xiaolai13138/drawing-board/altium desigener/主板RT1064/原理图 RT1064主板 V3.0.1.1 (1).pdf

D | D
C | C
B | B
A | A
RT1064_MotherBoard | 追猎者
| V3.0.1.1
2023/5/8 | 17:56:21
Title: | Author:

Date:

Revision:

Size: A4 | Time: | Sheet: | of:

Subtitle: Revision

V1.3

正式售卖的第一个版本
V2.0

内部迭代，未销售
V2.1

稳压方案更换为SY8205
增加2个舵机接口，与电机驱动信号接口2复用
增加USART4接口，方便连接OpenART mini

电源开关更换为软开关，避免电弧造成开关损耗

HC-SR1一体式超声波接口变更为3.3V供电
增加CR引脚延时泄放二极管

(2021)

(2020)

V2.2

减小电机PWM信号上串接的电阻为100R
稳压方案替换为SCT2450

(内部迭代)

用户按键及拨码开关增加100R串联电阻
USART4 USART1 无线串口接口，增加供电时序控制电路 软开关更改为P-MOS，断VCC的方案

V2.3 (2022)

更正软开关电路

UART1 UART4 无线串口接口的5V引脚丝印标注更改为5V*

USART1 USART4 丝印标注更改为 UART1 UART4

V3.0 (2022)

5V稳压输出端增加SS54二极管
去掉FlexCom摄像头接口
重新分配电机、舵机、编码器、按键、拨码开关引脚。
增加SPI-无线模块接口
增加磁铁检测模块接口

5V稳压和舵机稳压更换为SP1N28STER

# SEEKFREE

# SS54 SEEKFREE

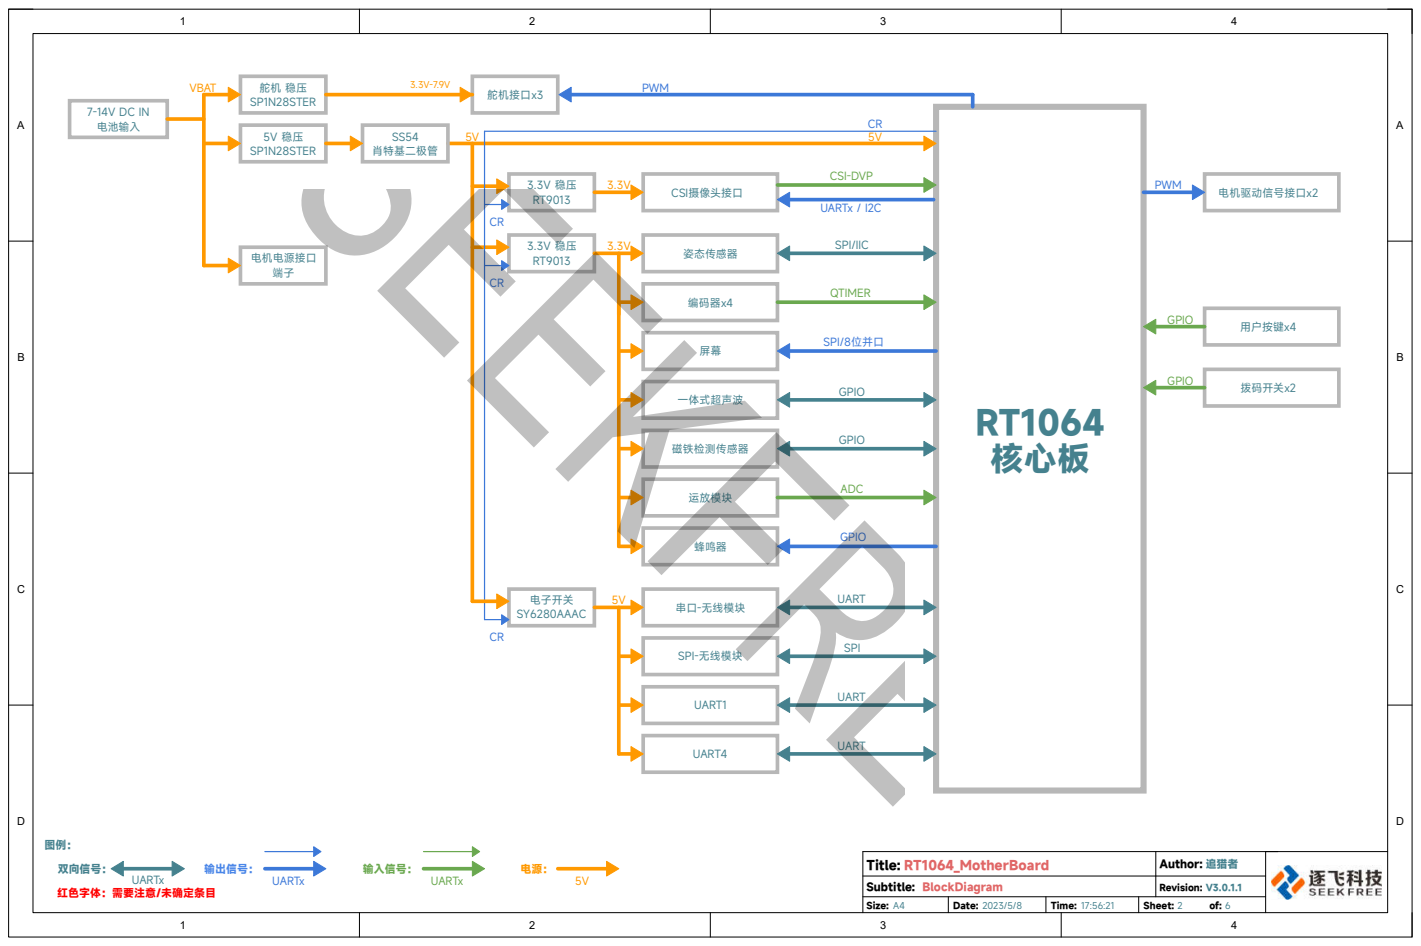
[picture p1: page 2]
RT1064_MotherBoard; 追猎者; Title:; Author:; Revision:; Subtitle: BlockDiagram; 双向信号：; 输出信号：; 输入信号：; 5V 稳压 SP1N28STER; VBAT; 电池输入; 舵机 稳压 SP1N28STER; 电机电源接口 端子; 舵机接口x3 ³.3V-7.9V; CSI摄像头接口; 姿态传感器; 编码器x4; SPI-无线模块; 一体式超声波; UART1; UART4; UARTx / I2C; UARTx; CSI-DVP; SPI/IIC; QTIMER; SPI/8位并口; 电子开关 SY6280AAAC; GPIO; 串口-无线模块; 磁铁检测传感器; UART; SPI; PWM; 运放模块; 蜂鸣器; ADC; 电机驱动信号接口x2 PWM; 用户按键x4 GPIO; 拨码开关x2 GPIO; RT1064 核心板; 肖特基二极管

红色字体：需要注意/未确定条目

# RT1064核心板

## 外设 功能

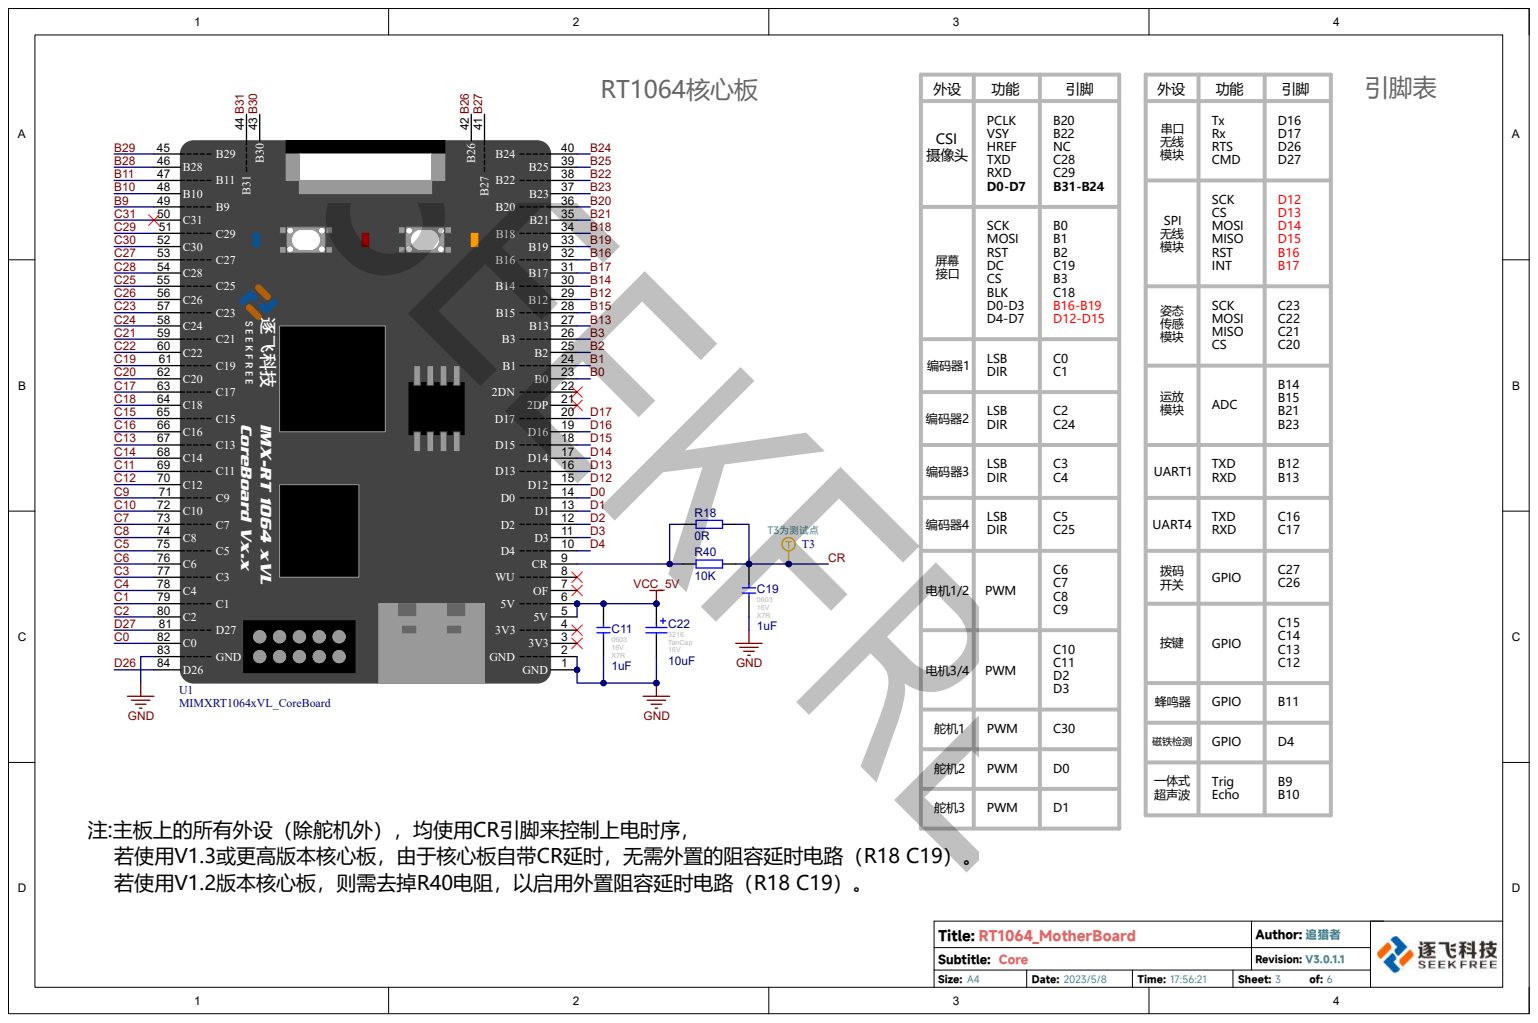
[picture p2: page 3]

SPI 无线 模块 | SCK CS MOSI MISO RST INT | D12 D13 D14 D15 B16 B17

屏幕 接口 | SCK MOSI RST DC CS BLK D0-D3 D4-D7 | B0 B1 B2 C19 B3 C18 B16-B19 D12-D15

姿态 传感 模块 | SCK MOSI MISO CS | C23 C22 C21 C20

编码器1 | LSB DIR | C0 C1

运放 模块 | ADC | B14 B15 B21 B23

编码器2 | LSB DIR | C2 C24

按键 | GPIO | C15 C14 C13 C12

电机3/4 | PWM | C10 C11 D2 D3

蜂鸣器 | GPIO | B11

舵机1 | PWM | C30

磁铁检测 | GPIO | D4

舵机2 | PWM | D0

一体式 超声波 | Trig Echo | B9 B10

舵机3 | PWM | D1

# CSI摄像头接口

# 姿态传感模块接口

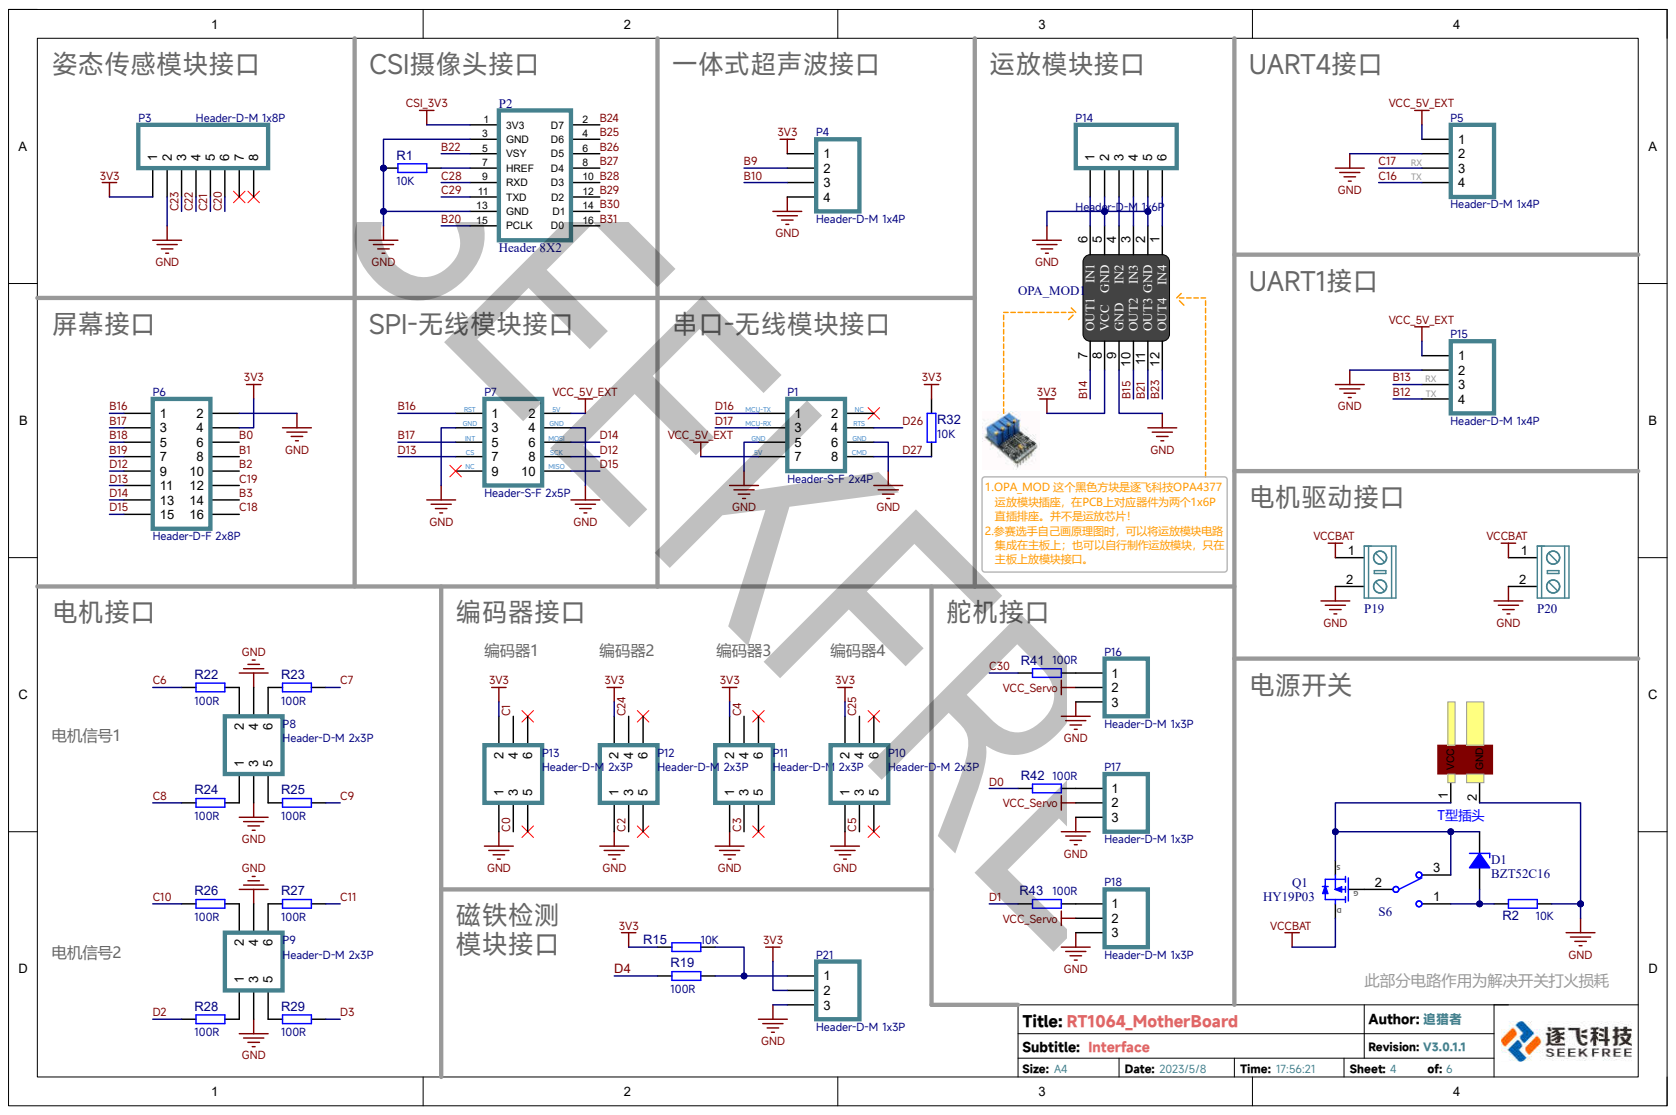
[picture p3: page 4]

# 3V3电源

# 舵机稳压电路

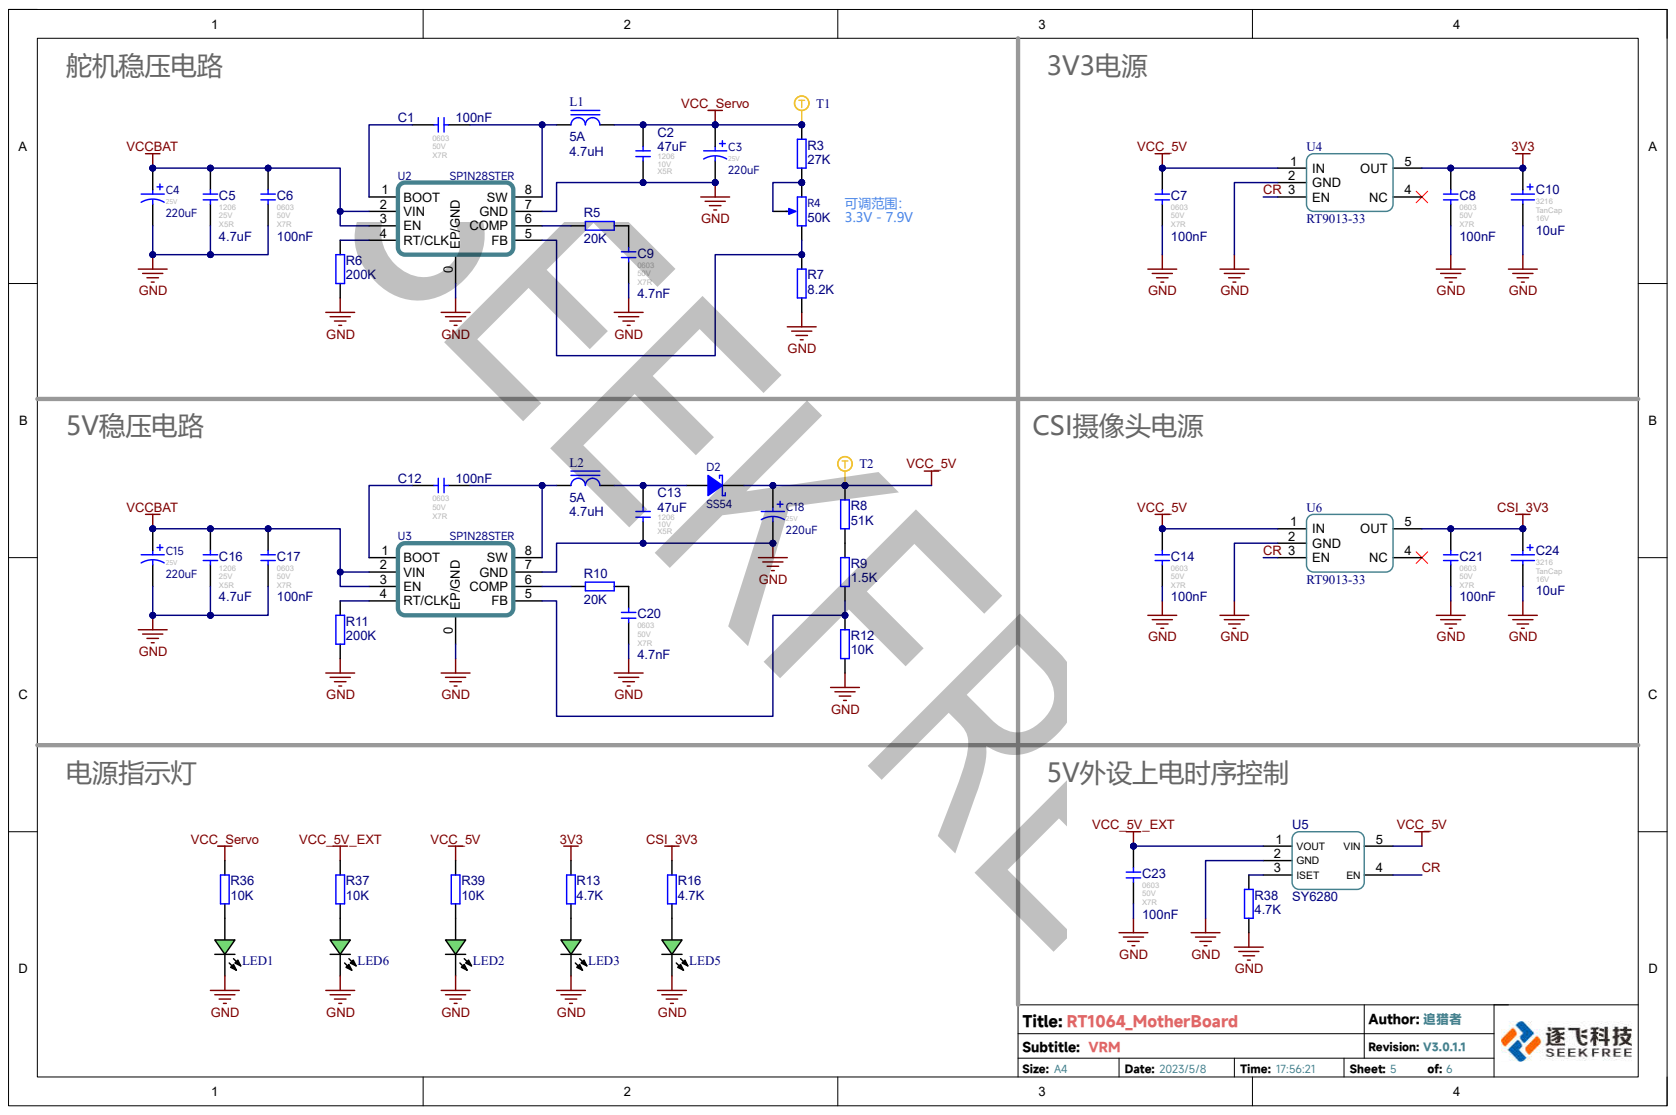
[picture p4: page 5]

# 蜂鸣器 拨码开关/按键

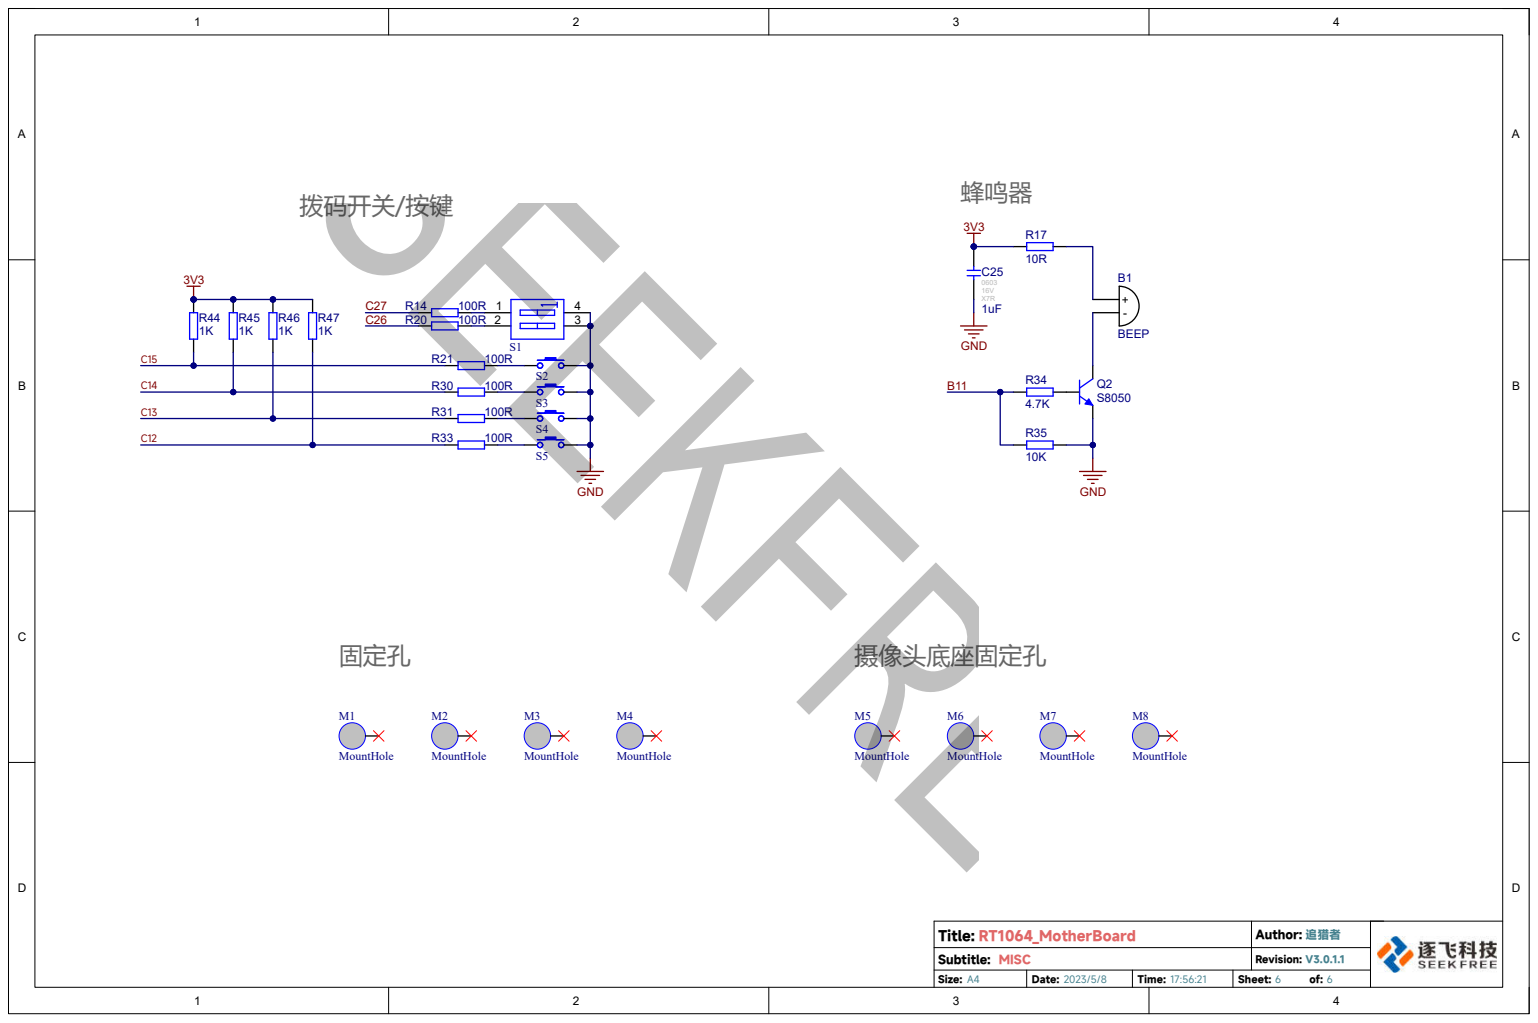
[picture p5: page 6]
