xiaolai13138/drawing-board/altium desigener/驱动板DRV8701E/DRV8701E_V1/DRV8701E_V1.pdf

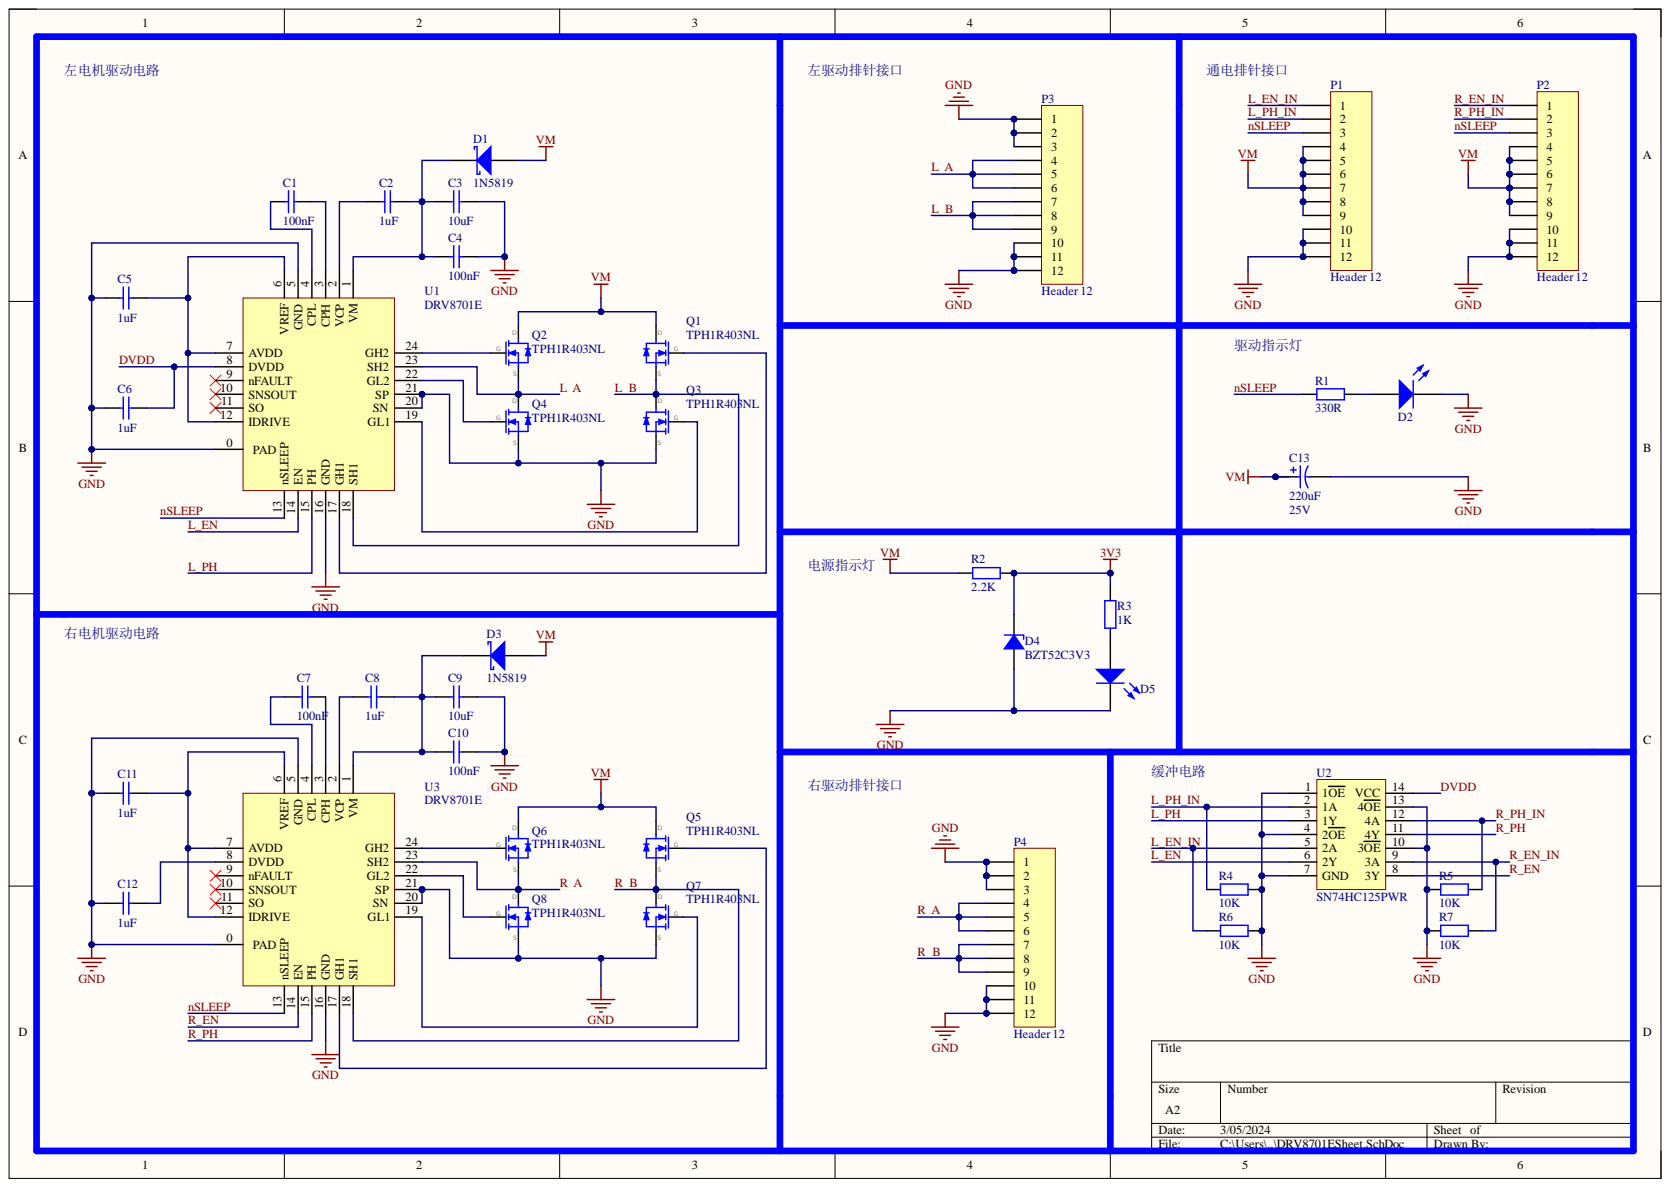
[picture p13: page 1]

VM 1 VCP 2 CPH 3 CPL 4 GND 5 VREF 6 nSLEEP 13

Size A2 | Number | Revision

Date: 3/05/2024 | Sheet of
File: C:\Users\..\DRV8701ESheet.SchDoc | Drawn By:

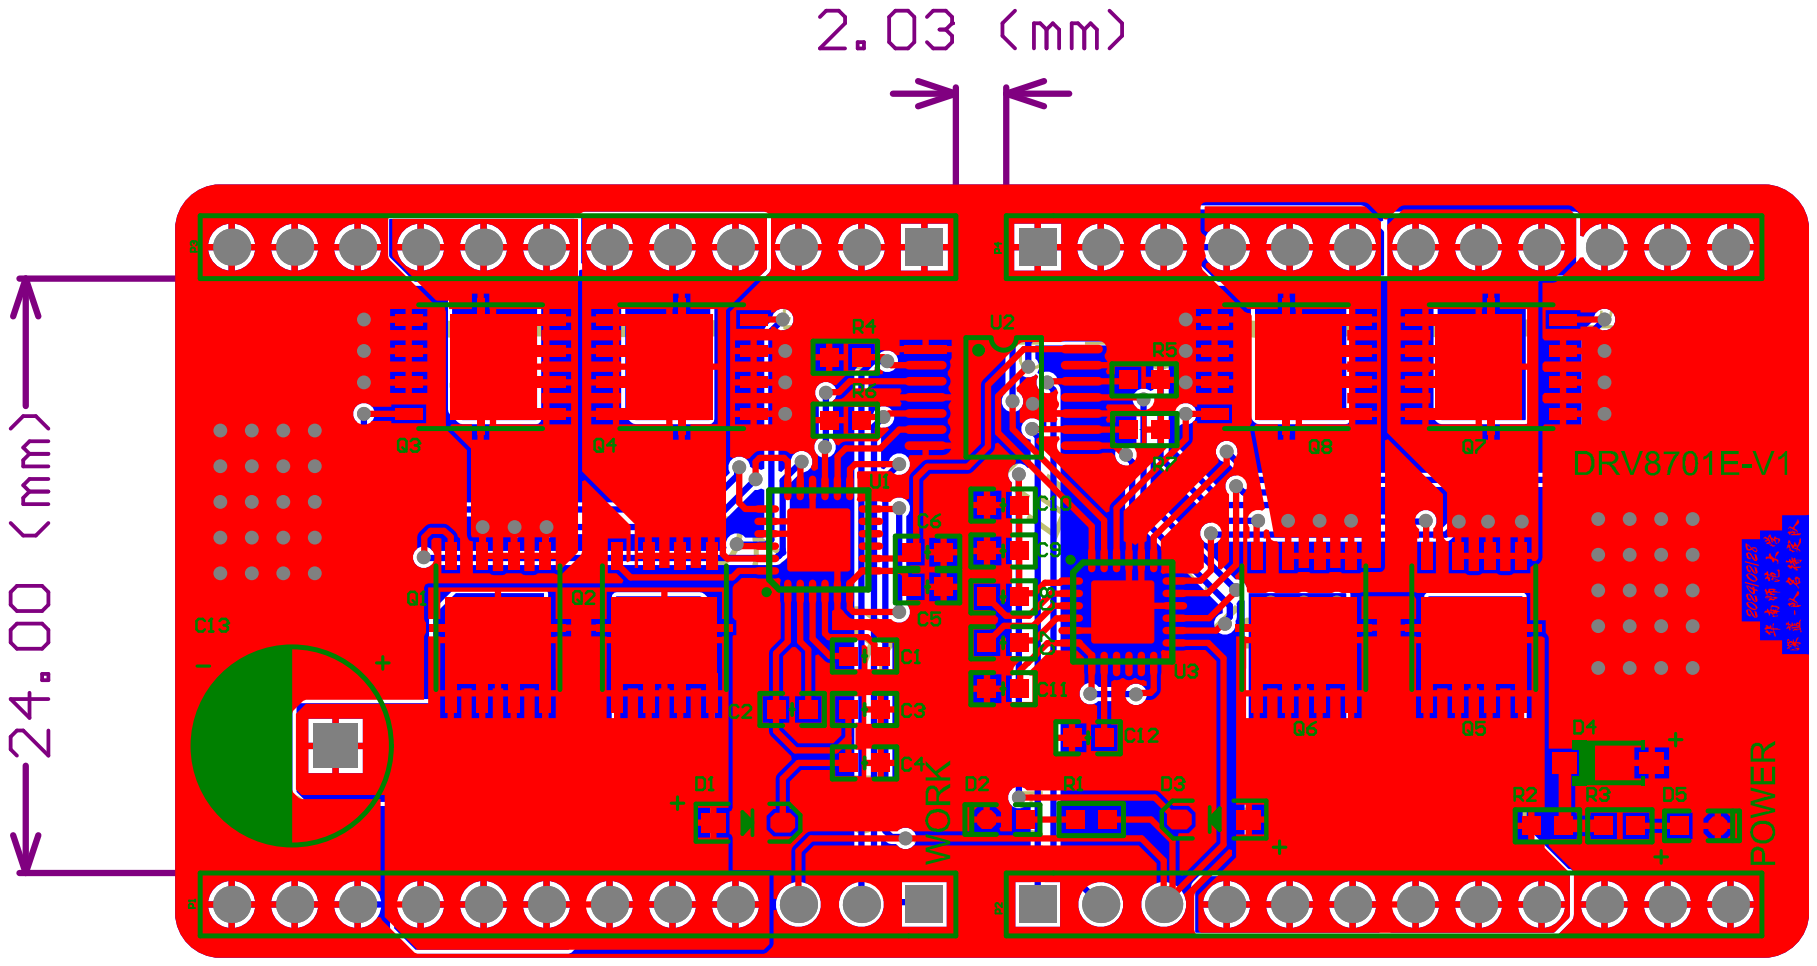
[picture p14: page 2]

Comment | Description | Designator | Footprint | LibRef | Quantity
100nF | 贴片电容 | C1, C4, C7, C10 | C0603_L | C-SMD | 4
1uF | 贴片电容 | C2, C5, C6, C8, C11, C12 | C0603_L | C-SMD | 6
10uF | 贴片电容 | C3, C9 | C0603_L | C-SMD | 2
220uF 25V | Polarized Capacitor (Radial) | C13 | CAPPR3.5-8X11.5 | Cap-Elect | 1
1N5819 | 肖特基二极管 | D1, D3 | SOD-323 | 1N5819 | 2
LED | 贴片发光二极管 | D2, D5 | LED-0603_R | LED_SMD | 2
BZT52C3V3 | 3.3V稳压二极管 | D4 | SOD-123-L | Diode Zen | 1
Header 12 | Header, 12-Pin | P1, P2, P3, P4 | HDR1X12 | Header 12 | 4
TPH1R403NL | N沟道MOS | Q1, Q2, Q3, Q4, Q5, Q6, Q7, Q8 | DFN5x6 | TPH1R403NL | 8
330R | 贴片电阻 | R1 | R0603_L | R-SMD | 1
2.2K | 贴片电阻 | R2 | R0603_L | R-SMD | 1
1K | 贴片电阻 | R3 | R0603_L | R-SMD | 1
10K | 贴片电阻 | R4, R5, R6, R7 | R0603_L | R-SMD | 4
DRV8701E | DRV8701E Ti全桥驱 动芯片 | U1, U3 | QFN24-4x4 | DRV8701E | 2
SN74HC125PWR | 三态输出的四路缓 冲器 | U2 | TSSOP14 | SN74HC125PWR | 1
