xiaolai13138/drawing-board/(list of files, drawings)

Other design files:
altium desigener/主板RT1064/RT1064_V1/RT1064_V1/RT1064_V1.PrjPcb
altium desigener/主板RT1064/RT1064_V1/RT1064_V1主板器件封装集成库/RT1064_V1主板器件封装集成库/Project Outputs for RT1064_V1主板器件封装集成库/RT1064_V1主板器件封装集成库/RT1064_MotherBoard V3.SCHLIB
altium desigener/主板RT1064/RT1064_V1/RT1064_V1主板器件封装集成库/RT1064_V1主板器件封装集成库/RT1064_MotherBoard V3.SCHLIB
altium desigener/主板RT1064/RT1064_V1/RT1064_V2/board/board/board.PrjPcb
altium desigener/主板RT1064/RT1064_V1/RT1064_V2/board/board/boardPCB.PcbDoc
altium desigener/主板RT1064/RT1064_V1/RT1064_V2/board/board/boardSheet.SchDoc
altium desigener/主板RT1064/RT1064_V1/RT1064_V2/RT1064/RT1064_CoreBoard.SchDoc
altium desigener/主板RT1064/RT1064_V1/RT1064_V2/RT1064/RT1064_Device.SchDoc
altium desigener/主板RT1064/RT1064_V1/RT1064_V2/RT1064/RT1064_Interaction.SchDoc
altium desigener/主板RT1064/RT1064_V1/RT1064_V2/RT1064/RT1064_Power.SchDoc
altium desigener/主板RT1064/RT1064_V1/RT1064_V2/RT1064/RT1064_V1/RT1064_V1.SCHLIB
altium desigener/主板RT1064/RT1064_V1/RT1064_V2/RT1064/RT1064_V2.PrjPcb
altium desigener/主板RT1064/RT1064_V1/RT1064_V2/RT1064/RT1064_V11/RT1064_V1.SCHLIB
altium desigener/主板RT1064/RT1064_V1/排母.SchLib
altium desigener/驱动板DRV8701E/DRV8701E_V1/DRV8701EPCB.PcbDoc
altium desigener/驱动板DRV8701E/DRV8701E_V3/DRV8701E_V1.PrjPcb
altium desigener/驱动板DRV8701E/DRV8701E_V3/DRV8701ESheet.SchDoc
