xiaolai13138/drawing-board/(commit log)

2024-02-25 驱动板工程初建
    [DRV8701EPCB.PcbDoc, DRV8701ESheet.SchDoc, DRV8701E_V1.PrjPcb, 智能车驱动板DRV8701E.SCHLIB]
2024-02-27 四层板层叠设置
    [智能车驱动板DRV8701E.SCHLIB]
2024-02-27 模块化布局1
    [DRV8701EPCB.PcbDoc, DRV8701ESheet.SchDoc, DRV8701E_V1.PrjPcb]
2024-02-27 模块化布局2
    [DRV8701EPCB.PcbDoc]
2024-02-28 布线+过孔
    [DRV8701EPCB.PcbDoc, DRV8701ESheet.SchDoc, DRV8701E_V1.PrjPcb]
2024-02-29 驱动板优化布线+铺铜
    [DRV8701EPCB.PcbDoc]
2024-02-29 修改丝印与加队名
    [DRV8701ESheet.SchDoc, DRV8701E_V1.PrjPcb, DRV8701E_V1购买清单.xlsx]
2024-02-29 丝印调整位置
2024-03-01 RT1064绘制原理图1
    [DRV8701EPCB_Copper_Plane_1.gbr, DRV8701EPCB_Copper_Plane_2.gbr, DRV8701EPCB_Copper_Signal_Bot.gbr, DRV8701EPCB_Copper_Signal_Top.gbr, DRV8701EPCB_Drawing_1.gbr, DRV8701EPCB_Drillmap_1.gbr, DRV8701EPCB_Keep-out.gbr, DRV8701EPCB_Legend_Bot.gbr]
2024-03-02 RT1064原理图元器件选型
    [RT1064_CoreBoard.SchDoc, RT1064_Device.SchDoc, RT1064_Interaction.SchDoc, RT1064_MotherBoard V3.SCHLIB, RT1064_Power.SchDoc, 排母.SchLib]
2024-03-03 RT1064主板PCB布线+铺铜
    [RT1064_Device.SchDoc, RT1064_Interaction.SchDoc, RT1064_Power.SchDoc, RT1064_V1.PrjPcb]
2024-03-03 pgnd和gnd铺铜
2024-03-03 修改铺铜
    [RT1064_Device.SchDoc, RT1064_Power.SchDoc, RT1064_V1.SCHLIB]
2024-03-04 修改丝印1
2024-03-07 RT1064第二版构思和修改
    [DRV8701E_V1.PrjPcb, RT1064_CoreBoard.SchDoc, RT1064_Device.SchDoc, RT1064_Interaction.SchDoc, RT1064_Power.SchDoc, RT1064_V1.SCHLIB, RT1064_V1.xlsx, RT1064_V2.PrjPcb]
2024-03-10 DRV8701第二版完成
    [DRV8701EPCB_Copper_Plane_1.gbr, DRV8701EPCB_Copper_Plane_2.gbr, DRV8701EPCB_Copper_Signal_Bot.gbr, DRV8701EPCB_Copper_Signal_Top.gbr, DRV8701EPCB_Drawing_1.gbr, DRV8701EPCB_Drillmap_1.gbr, DRV8701EPCB_Keep-out.gbr, DRV8701EPCB_Legend_Bot.gbr]
2024-03-14 DRV8701V2线路优化+RT1064原理图元件封装修改（完成画原理图）+PCB模块化布局1
    [DRV8701EPCB_Copper_Plane_1.gbr, DRV8701EPCB_Copper_Plane_2.gbr, DRV8701EPCB_Copper_Signal_Bot.gbr, DRV8701EPCB_Copper_Signal_Top.gbr, DRV8701EPCB_Drawing_1.gbr, DRV8701EPCB_Drillmap_1.gbr, DRV8701EPCB_Keep-out.gbr, DRV8701EPCB_Legend_Bot.gbr]
2024-03-15 RT1064布局优化2
    [RT1064_Device.SchDoc]
2024-03-15 DRV第三版布局修改
    [DRV8701ESheet.SchDoc, RT1064_CoreBoard.SchDoc, RT1064_Interaction.SchDoc]
2024-03-15 RT1064布局优化
2024-03-17 RT1064小修改
2024-03-19 RT1064信号线优化
2024-03-20 RT1064铺铜
2024-03-24 DRV驱动板丝印修改
2024-03-25 主板增加舵机和电磁铁
    [RT1064_CoreBoard.SchDoc, RT1064_Device.SchDoc]
2024-03-26 主板RT1064修改PCB
2024-03-27 主板V2-T型插头修改+丝印添加
    [RT1064_Device.SchDoc, RT1064_V1.SCHLIB]
2024-03-27 主板V2_丝印最终版
2024-03-28 RT1064丝印修改
2024-03-28 RT1064_V2最终版
2024-03-29 硬件导出PDF
    [DRV8701E_V1.PrjPcb, RT1064_V2.PrjPcb]
2024-03-31 主板修改
    [RT1064_CoreBoard.SchDoc, RT1064_Device.SchDoc]
2024-04-02 驱动板外形层小修改
